dunk8888/rf-transmitter/pcb/rf-transmitter.brd

## EAGLE design pcb/rf-transmitter.brd (2016-03-20)

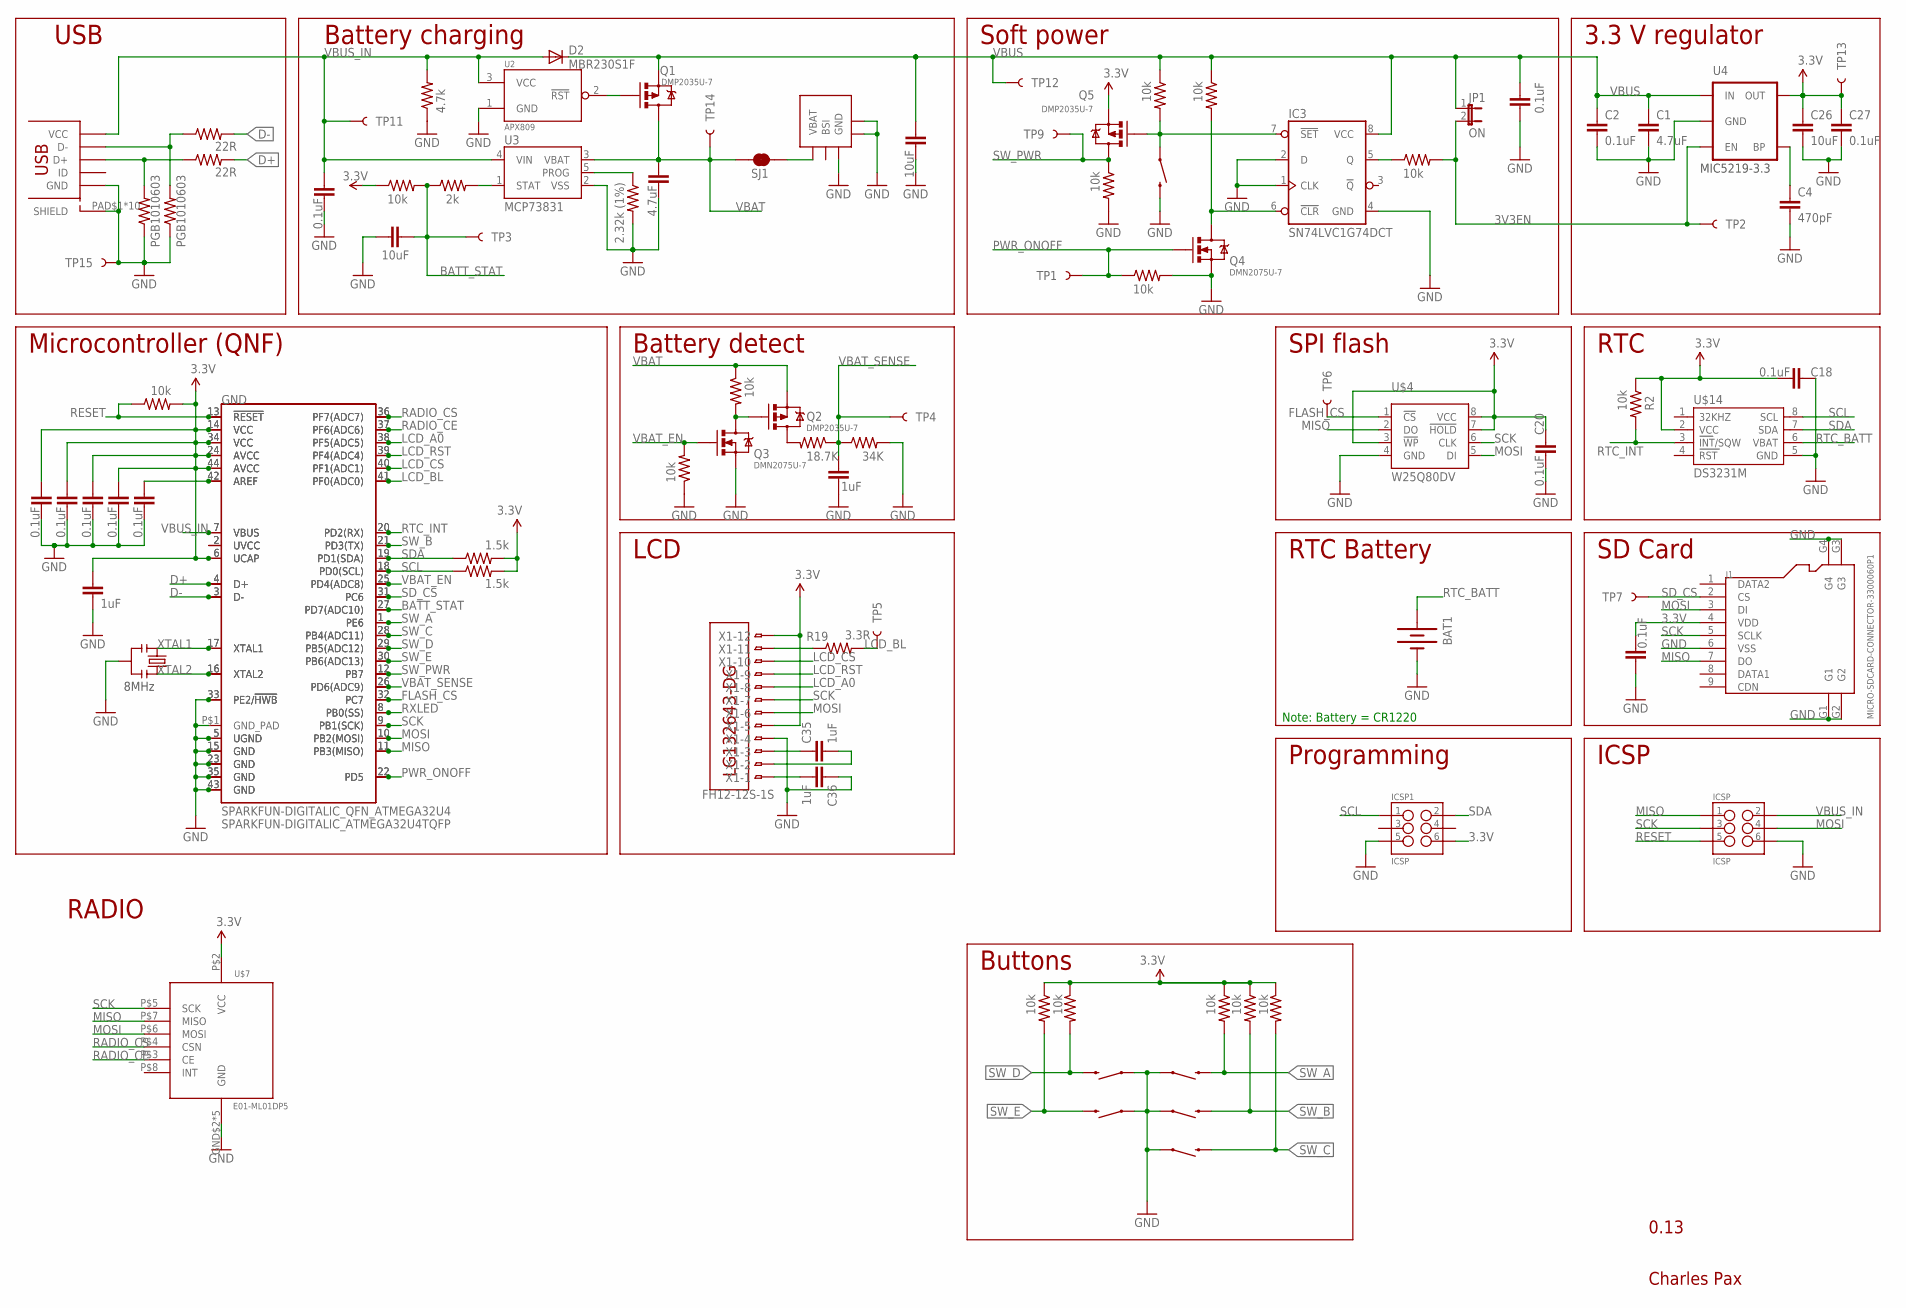
[picture p1: schematic rf-transmitter.sch]

Parts:
BAT1: BATTERY12MM; BATTCON_12MM; MPN 3000TR
C1, C9: 4.7uF; SPARKFUN-CAPACITORS_0603-CAP
C2, C3, C5, C6, C18, C20, C21, C27, C28, C32, C33, C34: 0.1uF; SPARKFUN-CAPACITORS_0603-CAP
C4: 470pF; SPARKFUN-CAPACITORS_0603-CAP
C12, C22, C26: 10uF; SPARKFUN-CAPACITORS_0603-CAP
C19, C23, C35, C36: 1uF; SPARKFUN-CAPACITORS_0603-CAP
D2: MBR230S1F; SOD123; MPN MBR230S1F-7
GND: SPARKFUN-DIGITALIC_QFN_ATMEGA32U4; SPARKFUN-DIGITALIC_SPARKFUN-DIGITALIC_QFN-44; MPN ATMEGA32U4-MU
IC3: SN74LVC1G74DCT; SSOP8; MPN SN74LVC1G74DCTR
ICSP, ICSP1: ICSP; SPARKFUN-CONNECTORS_2X3_SMT_POSTS_PAXINSTRUMENT; MPN 95278-101A06LF
J1: MICRO-SDCARD-CONNECTOR-3300060P1; 9P-SMD-W-RING; MPN ST-TF-003A
JP1: ON; SJ_2S-NO; MPN N/A
Q1, Q2, Q5: DMP2035U-7; SOT23; MPN DMP2035U-7
Q3, Q4: DMN2075U-7; SOT23; MPN DMN2075U-7
R1, R2, R4, R5, R6, R7, R8, R11, R12, R15, R16, R18, R21, R22, R23: 10k; SPARKFUN-RESISTORS_0603-RES
R3: 2.32k (1%); SPARKFUN-RESISTORS_0603-RES
R9, R10: 22R; SPARKFUN-RESISTORS_0603-RES
R13, R14: 1.5k; SPARKFUN-RESISTORS_0603-RES
R17: 2k; SPARKFUN-RESISTORS_0603-RES
R19: 3.3R; SPARKFUN-RESISTORS_0603-RES
R20: 18.7K; SPARKFUN-RESISTORS_0603-RES
R24: 34K; SPARKFUN-RESISTORS_0603-RES
R25: 4.7k; SPARKFUN-RESISTORS_0603-RES
S1, S2, S3, S4, S5, S6: SWITCH-MOMENTARY-2SMD; TACTILE_SWITCH_SMD; MPN RS-187R05A2-DS MT RT
SJ1: JUMPER-PAD-2-NC_BY_TRACE; PAD-JUMPER-2-NC_BY_TRACE_YES_SILK; MPN N/A
TP1: PWR_ONOFF; TP_15TH; MPN N/A
TP2: 3V3_EN; TP_15TH; MPN N/A
TP3: BATT_STAT; TP_15TH; MPN N/A
TP4: VBAT_SENSE; TP_15TH; MPN N/A
TP5: LCD_BL; TP_15TH; MPN N/A
TP6: FLASH_CS; TP_15TH; MPN N/A
TP7: SD_CS; TP_15TH; MPN N/A
TP9: SW_PWR; TP_15TH; MPN N/A
TP11: VBUS_IN; TP_15TH; MPN N/A
TP12: VBUS; TP_15TH; MPN N/A
TP13: 3.3V; TP_15TH; MPN N/A
TP14: VBAT; TP_15TH; MPN N/A
TP15: GND; TP_15TH; MPN N/A
U2: APX809; SOT23; MPN APX809-44SAG-7
U3: MCP73831; SOT23-5; MPN MCP73832T-2DCI/OT
U4: MIC5219-3.3V; SOT23-5; MPN MIC5219-3.3YM5 TR
U$1: USB_MICROSMT+THRUHULE; USB_MICRO_THRUHOLE; MPN 10118194-0001LF
U$2: BL-5C-CONNECTOR; MPN BC-4-3P (77H)
U$3: SPARKFUN-DIGITALIC_ATMEGA32U4TQFP; SPARKFUN-DIGITALIC_SPARKFUN-DIGITALIC_TQFP44; MPN ATMEGA32U4-AU
U$4: W25Q80DV; CHARLESPAX_SOIC8M; MPN W25Q80DVSSIG-ND
U$5: LG132643-DG; MPN LG132643-DW
U$7: E01-ML01DP5
U$14: DS3231M; SOIC8; MPN DS3231MZ+
X1: FH12-12S-1S; FH12-12S-1SH; MPN FH12-12S-1SH(55)
Y1: RESONATORSMD; RESONATOR-SMD; MPN CSTCE8M00G52-R0
Z1, Z2: PGB1010603; SPARKFUN-RESISTORS_0603-RES; MPN PGB1010603NRHF

Connections:
3.3V: C5.1, C18.1, C19.1, C20.2, C21.2, C26.1, C27.1, C32.1, C33.1, C34.1, GND.6 (UCAP), GND.14 (VCC), GND.24 (AVCC), GND.34 (VCC), GND.44 (AVCC), ICSP1.6, J1.4 (VDD), Q5.2 (S), R1.1, R2.1, R4.2, R8.1, R11.1, R12.1, R13.2, R14.2, R15.1, R16.1, TP13.P$1, U4.5 (OUT), U$3.6 (UCAP), U$3.14 (VCC), U$3.24 (AVCC), U$3.34 (VCC), U$3.44 (AVCC), U$4.3 (!WP), U$4.7 (!HOLD), U$4.8 (VCC), U$7.P$2 (VCC), U$14.2 (VCC), X1.5, X1.12
3V3EN: JP1.2, R21.2, TP2.P$1, U4.3 (EN)
BATT_STAT: C22.1, GND.27 (PD7(ADC10)), R1.2, R17.1, TP3.P$1, U$3.27 (PD7(ADC10))
D+: GND.4 (D+), R9.2, U$3.4 (D+)
D-: GND.3 (D-), R10.2, U$3.3 (D-)
FLASH_CS: GND.32 (PC7), TP6.P$1, U$3.32 (PC7), U$4.1 (!CS)
GND: BAT1.GND (-), C1.2, C2.2, C3.2, C4.2, C5.2, C6.2, C9.2, C12.2, C18.2, C19.2, C20.1, C21.1, C22.2, C23.2, C26.2, C27.2, C28.2, C32.2, C33.2, C34.2, C36.1, GND.5 (UGND), GND.15 (GND), GND.23 (GND), GND.33 (PE2/!HWB), GND.35 (GND), GND.43 (GND), GND.P$1 (GND_PAD), IC3.1 (CLK), IC3.2 (D), IC3.4 (GND), ICSP.6, ICSP1.5, J1.6 (VSS), J1.G1, J1.G2, J1.G3, J1.G4, Q3.2 (S), Q4.2 (S), R3.2, R18.2, R22.2, R23.1, R24.2, R25.1, S1.1, S2.1, S3.1, S4.1, S5.1, S6.3 (2), TP15.P$1, U2.1 (GND), U3.2 (VSS), U4.2 (GND), U$1.PAD$1 (SHIELD), U$1.PAD$2 (SHIELD), U$1.PAD$3 (SHIELD), U$1.PAD$4 (SHIELD), U$1.PAD$5 (SHIELD), U$1.PAD$6 (SHIELD), U$1.PAD$7 (SHIELD), U$1.PAD$8 (SHIELD), U$1.PAD$9 (SHIELD), U$1.PAD$10 (SHIELD), U$1.PIN$5 (GND), U$2.P$3 (GND), U$2.P$4, U$2.P$5, U$3.5 (UGND), U$3.15 (GND), U$3.23 (GND), U$3.33 (PE2/!HWB), U$3.35 (GND), U$3.43 (GND), U$4.4 (GND), U$7.GND$2 (GND), U$7.GND$3 (GND), U$7.GND$4 (GND), U$7.GND$5 (GND), U$7.P$1 (GND), U$14.5 (GND), X1.4, Y1.2, Z1.1, Z2.1
LCD_A0: GND.38 (PF5(ADC5)), U$3.38 (PF5(ADC5)), X1.8
LCD_BL: GND.41 (PF0(ADC0)), R19.2, TP5.P$1, U$3.41 (PF0(ADC0))
LCD_CS: GND.40 (PF1(ADC1)), U$3.40 (PF1(ADC1)), X1.10
LCD_RST: GND.39 (PF4(ADC4)), U$3.39 (PF4(ADC4)), X1.9
MISO: GND.11 (PB3(MISO)), ICSP.1, J1.7 (DO), U$3.11 (PB3(MISO)), U$4.2 (DO), U$7.P$7 (MISO)
MOSI: GND.10 (PB2(MOSI)), ICSP.4, J1.3 (DI), U$3.10 (PB2(MOSI)), U$4.5 (DI), U$7.P$6 (MOSI), X1.6
unnamed: C4.1, U4.4 (BP)
unnamed: R17.2, U3.1 (STAT)
unnamed: R19.1, X1.11
unnamed: R3.1, U3.5 (PROG)
unnamed: SJ1.2, U$2.P$1 (VBAT)
unnamed: Q1.1 (G), U2.2 (!RST)
unnamed: C3.1, GND.42 (AREF), U$3.42 (AREF)
unnamed: GND.2 (UVCC), U$3.2 (UVCC)
unnamed: Q2.3 (D), R20.2
unnamed: IC3.7 (!SET), Q5.1 (G), R6.2, S6.1
unnamed: Q2.1 (G), Q3.3 (D), R5.2
unnamed: IC3.6 (!CLR), Q4.3 (D), R7.2
unnamed: IC3.5 (Q), R21.1
unnamed: R10.1, U$1.PIN$2 (D-), Z2.2
unnamed: R9.1, U$1.PIN$3 (D+), Z1.2
unnamed: C35.1, X1.3
unnamed: C35.2, X1.2
unnamed: C36.2, X1.1
PWR_ONOFF: GND.22 (PD5), Q4.1 (G), R22.1, TP1.P$1, U$3.22 (PD5)
RADIO_CE: GND.37 (PF6(ADC6)), U$3.37 (PF6(ADC6)), U$7.P$3 (CE)
RADIO_CS: GND.36 (PF7(ADC7)), U$3.36 (PF7(ADC7)), U$7.P$4 (CSN)
RESET: GND.13 (!RESET), ICSP.5, R4.1, U$3.13 (!RESET)
RTC_BATT: BAT1.PWR@1 (+), U$14.6 (VBAT)
RTC_INT: GND.20 (PD2(RX)), R2.2, U$3.20 (PD2(RX)), U$14.3 (INT/SQW)
RXLED: GND.8 (PB0(SS)), U$3.8 (PB0(SS))
SCK: GND.9 (PB1(SCK)), ICSP.3, J1.5 (SCLK), U$3.9 (PB1(SCK)), U$4.6 (CLK), U$7.P$5 (SCK), X1.7
SCL: GND.18 (PD0(SCL)), ICSP1.1, R14.1, U$3.18 (PD0(SCL)), U$14.8 (SCL)
SDA: GND.19 (PD1(SDA)), ICSP1.2, R13.1, U$3.19 (PD1(SDA)), U$14.7 (SDA)
SD_CS: GND.31 (PC6), J1.2 (CS), TP7.P$1, U$3.31 (PC6)
SW_A: GND.1 (PE6), R8.2, S3.3 (2), U$3.1 (PE6)
SW_B: GND.21 (PD3(TX)), R11.2, S2.3 (2), U$3.21 (PD3(TX))
SW_C: GND.28 (PB4(ADC11)), R12.2, S1.3 (2), U$3.28 (PB4(ADC11))
SW_D: GND.29 (PB5(ADC12)), R15.2, S4.3 (2), U$3.29 (PB5(ADC12))
SW_E: GND.30 (PB6(ADC13)), R16.2, S5.3 (2), U$3.30 (PB6(ADC13))
SW_PWR: GND.12 (PB7), Q5.3 (D), R18.1, TP9.P$1, U$3.12 (PB7)
VBAT: C9.1, Q1.3 (D), Q2.2 (S), R5.1, SJ1.1, TP14.P$1, U3.3 (VBAT)
VBAT_EN: GND.25 (PD4(ADC8)), Q3.1 (G), R23.2, U$3.25 (PD4(ADC8))
VBAT_SENSE: C23.1, GND.26 (PD6(ADC9)), R20.1, R24.1, TP4.P$1, U$3.26 (PD6(ADC9))
VBUS: C1.1, C2.1, C12.1, C28.1, D2.C, IC3.8 (VCC), JP1.1, Q1.2 (S), R6.1, R7.1, TP12.P$1, U4.1 (IN)
VBUS_IN: C6.1, D2.A, GND.7 (VBUS), ICSP.2, R25.2, TP11.P$1, U2.3 (VCC), U3.4 (VIN), U$1.PIN$1 (VCC), U$3.7 (VBUS)
XTAL1: GND.17 (XTAL1), U$3.17 (XTAL1), Y1.1
XTAL2: GND.16 (XTAL2), U$3.16 (XTAL2), Y1.3

Notes on the sheet:
MIC5219-3.3
8MHz
USB
Battery charging
Soft power
3.3 V regulator
RTC
LCD
Buttons
Microcontroller (QNF)
ICSP
0.13
Programming
RTC Battery
Charles Pax
SPI flash
SD Card
Battery detect
Note: Battery = CR1220
RADIO

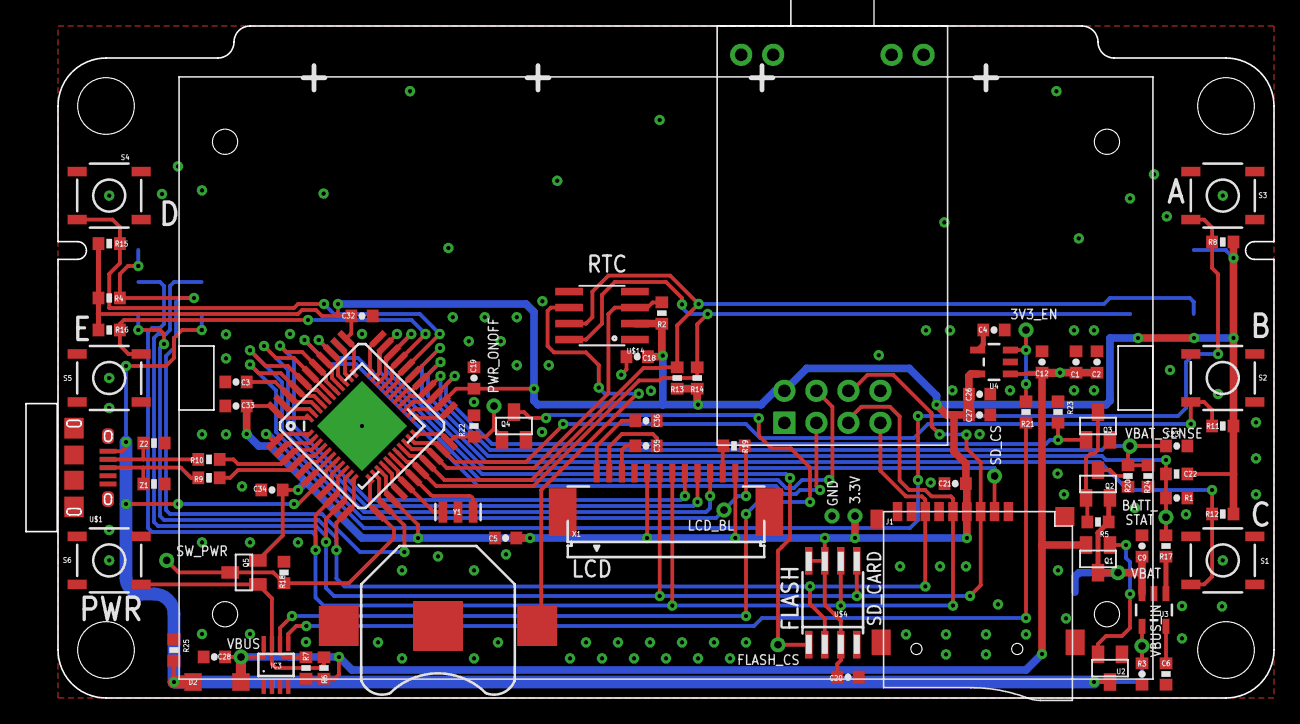
[picture p2: board rf-transmitter.brd from above]

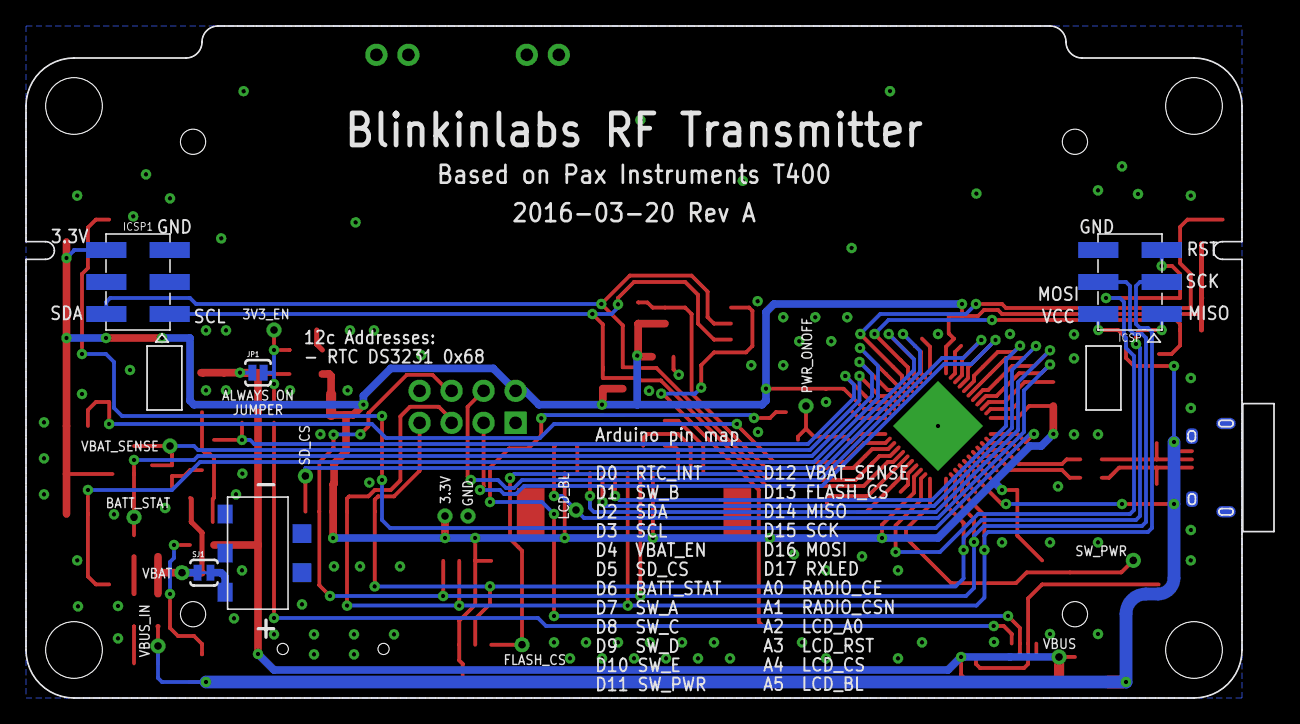
[picture p3: board rf-transmitter.brd from below]

Board: 2 copper layers, 99.1 x 53.3 mm, 94 parts (9 on the bottom side), 55 nets.
