dunk8888/rf-transmitter/firmware/buttons.cpp

#include "buttons.h"
#include "t400.h"
#include <avr/sleep.h>

namespace Buttons {

uint8_t stuckButtonMask;
uint8_t pendingButtons;

const uint8_t buttonPins[BUTTON_COUNT] = {
  BUTTON_A_PIN,
  BUTTON_B_PIN,
  BUTTON_C_PIN,
  BUTTON_D_PIN,
  BUTTON_E_PIN,
  BUTTON_POWER_PIN,
};

const uint8_t activeState[BUTTON_COUNT] = {
  LOW,
  LOW,
  LOW,
  LOW,
  LOW,
  HIGH,
};

void setup() {

  for(uint8_t b = 0; b < BUTTON_COUNT; b++) {
    if(activeState[b] == LOW) {
      pinMode(buttonPins[b], INPUT_PULLUP);
    }
  }

  // SW_A 	Logging start/stop 	INT3 	PD3
  EICRA |= 0x40;    // Configure INT3 to trigger on any edge
  EIMSK |= _BV(INT3);    // and enable the INT3 interrupt
  
  // SW_B 	Logging interval 	INT6 	PD2
  EICRB &= ~0x30;    // Configure INT6 to trigger on low level
  EIMSK |= _BV(INT6);    // and enable the INT6 interrupt

  // SW_C 	Temperature units 	PCINT4 	PB4
  // SW_D 	Toggle channels 	PCINT5 	PB5
  // SW_E 	Backlight               PCINT6 	PB6
  // SW_PWR      Power on/off            PCINT7  PB7
  PCMSK0 |= 0xF0;
  PCICR |= _BV(PCIE0);
}

uint8_t buttonDebounce = 0;

// Scan for new button presses
void buttonTask() {
  
  for(uint8_t b = 0; b < BUTTON_COUNT; b++) {
    if(bitRead(stuckButtonMask, b)) {
      if (digitalRead(buttonPins[b]) == !activeState[b]) {
        bitClear(stuckButtonMask, b);
      }
    }
    else {
      if (digitalRead(buttonPins[b]) == activeState[b]) {
        bitSet(stuckButtonMask, b);
        bitSet(pendingButtons, b);
      }
    }
  }
}


bool pending() {
  return (pendingButtons != 0);
}

// If a button was pressed, return it!
uint8_t getPending() {
  uint8_t button = BUTTON_COUNT;
  
  noInterrupts();

  for(uint8_t b = 0; b < BUTTON_COUNT; b++) {
    if (bitRead(pendingButtons, b)) {
      bitClear(pendingButtons, b);
      button = b;
      break;
    }
  }
  
  interrupts();
  
  return button;
}

} // namespace buttons

// button interrupts
ISR(INT6_vect) {
  // Workaround for the issue that ISR6 needs to be level sensitive to wake the processor from power down:
  // If we got here and SW_B was low (button pressed), switch to rising mode so we don't get stuck here
  // If we got here and SW_B was was high (button released), switch to level mode so we can wake the processor
  // In addition, don't put the processor in POWER_DOWN sleep mode when INT6 is level sensitive or SW_B won't
  // be able to wake the processor
  if(digitalRead(BUTTON_B_PIN) == LOW) {
    EICRB |= 0x30;    // Configure INT6 to trigger on rising edge
    set_sleep_mode(SLEEP_MODE_IDLE);
  }
  else {
    EICRB &= ~0x30;    // Configure INT6 to trigger on low level
    set_sleep_mode(SLEEP_MODE_PWR_DOWN);
  }
  
  Buttons::buttonTask();
}

ISR(INT3_vect) { Buttons::buttonTask();}
ISR(PCINT0_vect) { Buttons::buttonTask();}
